r2d2/ard-stuff/doc/ard-dht-lowpower.png

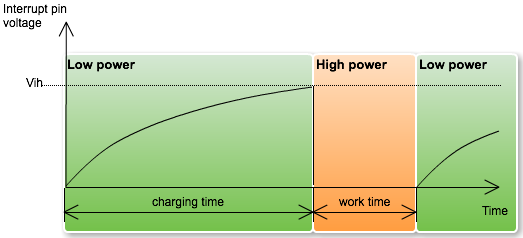
doc/ard-dht-lowpower.png
