r2d2/ard-stuff/ard-dht/hw/ard-dht.pdf

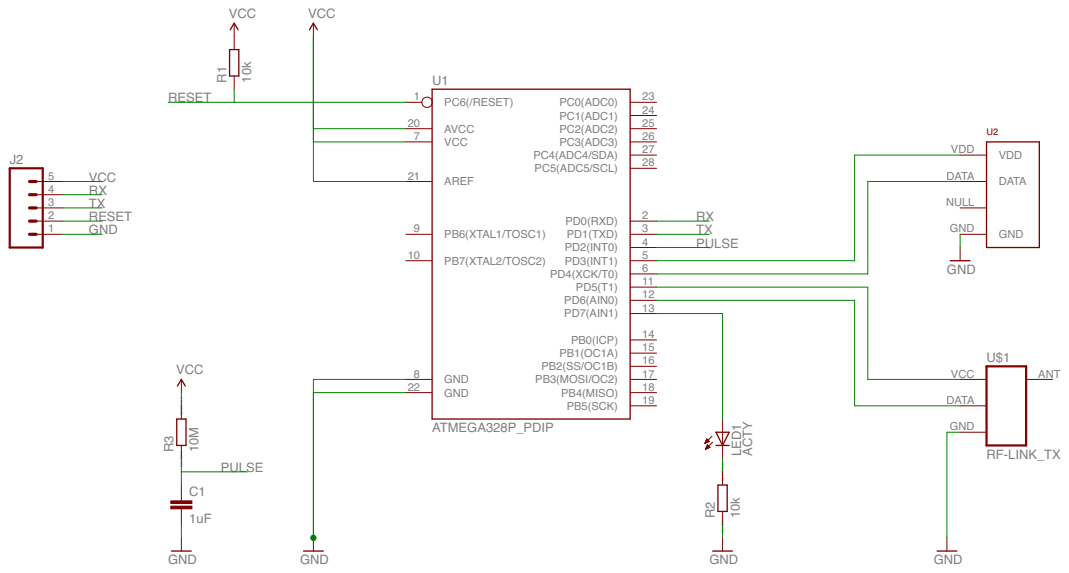
[picture p2: page 1]

SpiceOrder 1 SpiceOrder 2 SpiceOrder 1 SpiceOrder 2 ATMEGA328P_PDIP VCC GND VCC10k GND RF-LINK_TX GND GND ACTY 10k GND VCC1uF10M U1 PB5(SCK) 19 PB7(XTAL2/TOSC2) 10 PB6(XTAL1/TOSC1) 9 GND 8 GND 22 VCC 7 AREF 21 AVCC 20 PB4(MISO) 18 PB3(MOSI/OC2) 17 PB2(SS/OC1B) 16 PB1(OC1A) 15 PB0(ICP) 14 PD7(AIN1) 13 PD6(AIN0) 12 PD5(T1) 11 PD4(XCK/T0) 6 PD3(INT1) 5 PD2(INT0) 4 PD1(TXD) 3 PD0(RXD) 2 PC5(ADC5/SCL) 28 PC4(ADC4/SDA) 27 PC3(ADC3) 26 PC2(ADC2) 25 PC1(ADC1) 24 PC0(ADC0) 23 PC6(/RESET) 1 R1 VDD VDD DATA DATA NULL GND GND U$1 GND DATA VCC ANT J2 12345 LED1 R2 C1 R3 VCC GND RX RX TX TX RESET RESET PULSE PULSE U2
