r2d2/ard-stuff/ard-dht/hw/ard-dht.sch

## EAGLE design ard-dht/hw/ard-dht.sch (2016-02-05)

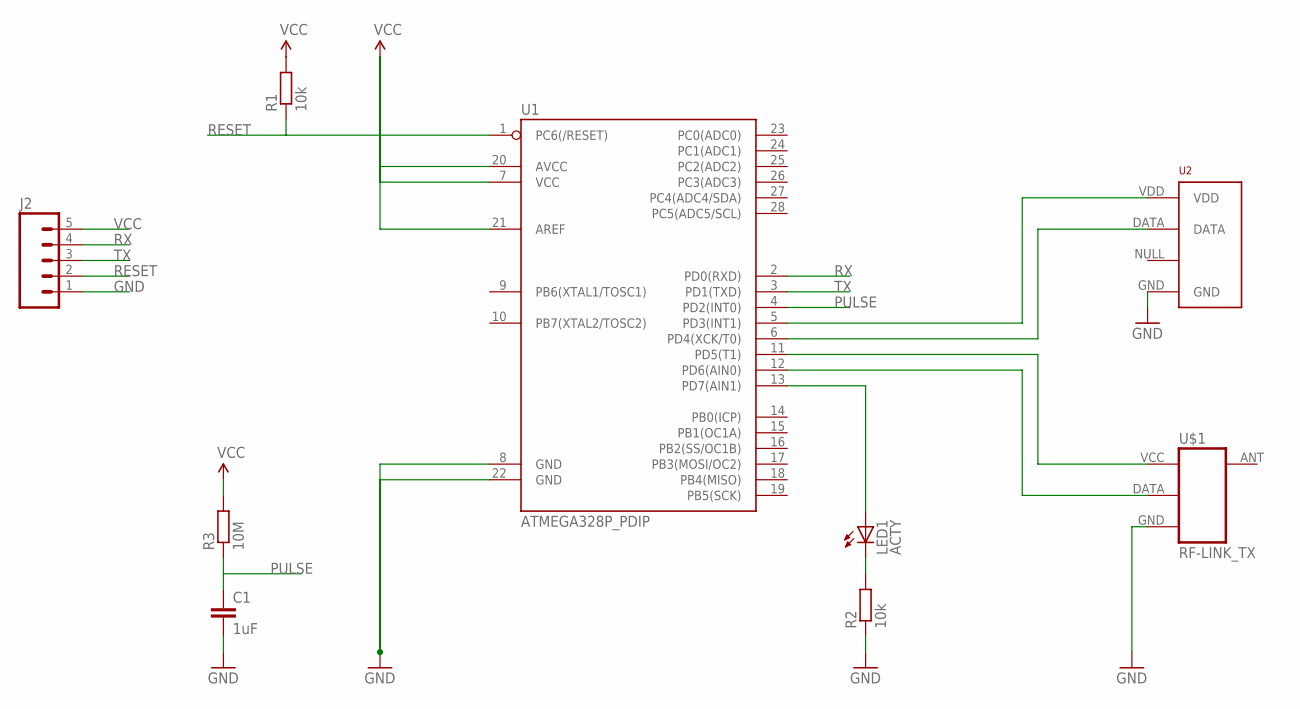
[picture p3: schematic ard-dht.sch]

Parts:
C1: 1uF; C5B5
J2: M05PTH_LONGPADS; 1X05_LONGPADS
LED1: ACTY; LED3MM
R1: 10k; 0207/10
R2: 10k; 0204/7
R3: 10M; 0204/7
U1: ATMEGA328P_PDIP; DIL28-3
U2: RHT03_DHT-22_AM2302; RHT03_DHT-22
U$1: RF-LINK_TX

Connections:
GND: C1.2, J2.1, R2.1, U1.8 (GND), U1.22 (GND), U2.GND, U$1.GND
unnamed: U1.5 (PD3(INT1)), U2.VDD
unnamed: U1.11 (PD5(T1)), U$1.VCC (+5V)
unnamed: LED1.A, U1.13 (PD7(AIN1))
unnamed: LED1.K (C), R2.2
unnamed: U1.6 (PD4(XCK/T0)), U2.DATA
unnamed: U1.12 (PD6(AIN0)), U$1.DATA
PULSE: C1.1, R3.1, U1.4 (PD2(INT0))
RESET: J2.2, R1.1, U1.1 (PC6(/RESET))
RX: J2.4, U1.2 (PD0(RXD))
TX: J2.3, U1.3 (PD1(TXD))
VCC: J2.5, R1.2, R3.2, U1.7 (VCC), U1.20 (AVCC), U1.21 (AREF)
