r2d2/ard-stuff/(commit log)

2016-01-28 First step commit:
    1/ Very basic oregon library
    2/ Basic Arduino code to handle Temp reading (DHT11 or DHT22), send data through RF mimic'ing Oregon protocol
2016-01-28 Add readVcc support to monitor battery level (untested)
2016-02-01 Adding EAGLE schematic file & pdf printed result.
    [ard-dht.sch]
2016-02-01 Adding link to the schematics of art-stuff
2016-02-05 identation rework Added Vcc printout
    [ard-dht.ino]
2016-02-05 Using I/O pins to provide power to : - Temperature sensor (DHT) - RF emitter The Atmega328p is now used fully in power down mode. Wake up is performed regularly by using an external RC pair. Moved al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
    [ard-dht.sch]
2016-02-05 changing interrupt type : not supported by all procs.
2016-02-06 Powering DHT before setup (otherwise auto detection fails) Also added a protection so if erratic readings happen, then just will be ignored
    [ard-dht.ino]
2016-02-10 Reworked of the Oregon Library to be able to support : Temperature devices (OSV2 protocol) Power devices (OSV3 protocol)
    Reworked ard-dht to cope with the library evolutions.
    Added a ard-power first draft.
    Note that the hardware part is still incorrect.
    I have a 74 Ohm burden resistor instead of the 33 Ohms.
    So (tried) to adapt the calibration, but still to review.
    But first tests show that my domoticz/RFXCOM sees correctly the device.
    [OSV2.cpp, OSV2.h, OSV3.cpp, OSV3.h, OregonPower.cpp, OregonPower.h, OregonTemp.cpp, OregonTemp.h]
2016-02-11 Correcting iPower & totalEnergy data
    [OregonPower.cpp, ard-power.ino, ard-roomba.ino]
2016-03-08 Using double "0.0" to check the temp/hum readings Check voltage against 3 1.5 batteries
2016-03-16 Using isnan() to check erratic values returned by the DHT sensor
